ayushrath63/TeamToast2019/README.md

Team Toast - Micromouse 2018-2019
======
Created by Ayush Rath and Emily Chen

Hardware (PCB) and software used to build and program a Micromouse robot
