ayushrath63/TeamToast2019/PCB/ToastSchematic.brd

## EAGLE design PCB/ToastSchematic.brd (2019-01-23)

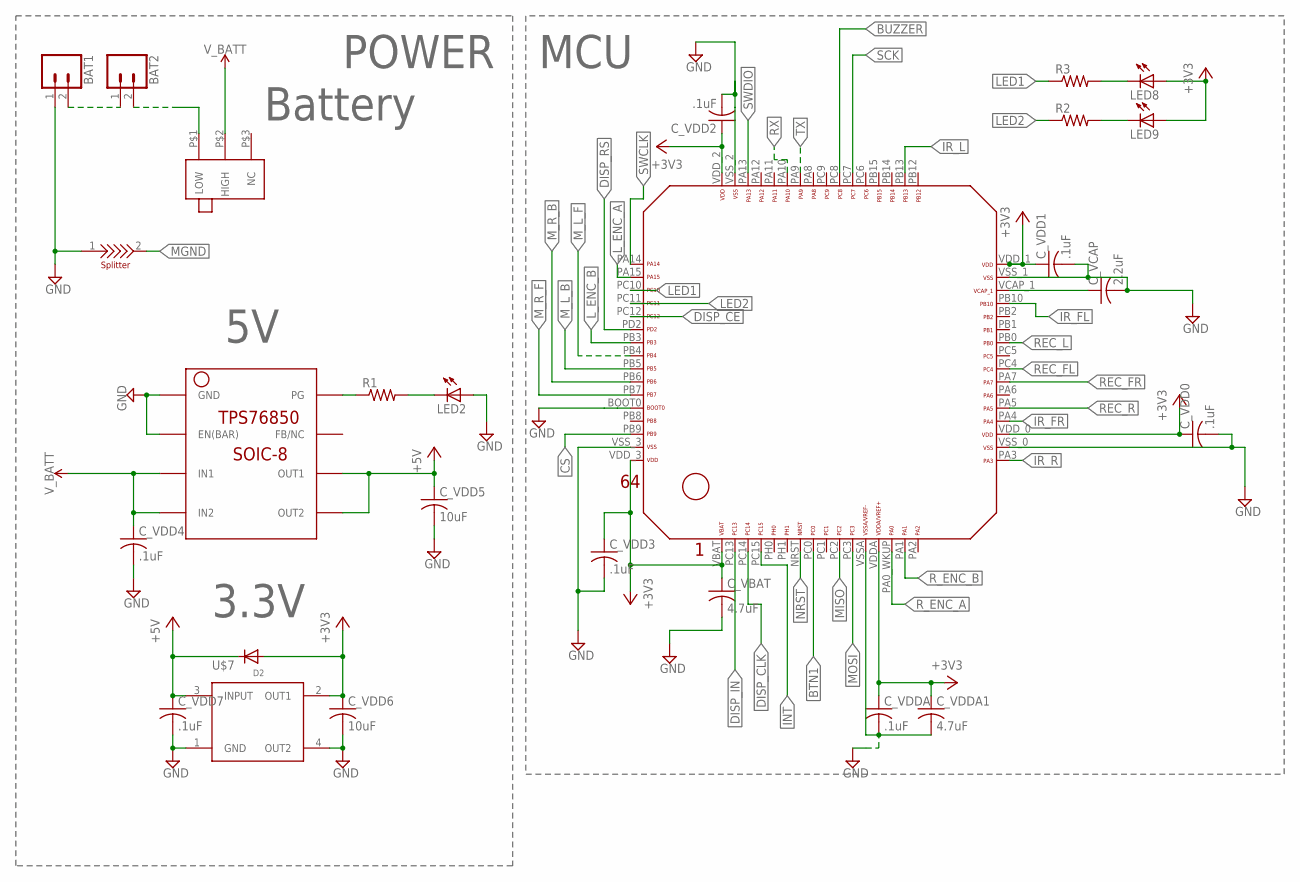
[picture p1: schematic ToastSchematic.sch, sheet 1]

Parts:
BAT1, BAT2: CONN_02JST-PTH-2; JST-2-PTH
C_VBAT: 4.7uF; C0603
C_VCAP: 2.2uF; C0603
C_VDD0, C_VDD1, C_VDD2, C_VDD3, C_VDD4, C_VDD7: .1uF; C0603
C_VDD5, C_VDD6: 10uF; C0603
C_VDDA: .1uF; C0603
C_VDDA1: 4.7uF; C0603
D2: DIODESOD-323F; SOD-323F
LED2, LED8, LED9: LEDCHIPLED_0603; CHIPLED_0603
R1, R2, R3: R-US_R0603; R0603
U$1: STM32F411/446_LQFP64
U$2: GH39P0
U$3: TPS76850(SOIC-8)
U$7: TLV1117; SOT-223
U$9: SPLITTER

Connections:
+3V3: C_VBAT.1, C_VDD0.1, C_VDD1.1, C_VDD2.1, C_VDD3.1, C_VDD6.1, C_VDDA.1, C_VDDA1.1, D2.A, LED8.A, LED9.A, U$1.VBAT, U$1.VDDA, U$1.VDD_0, U$1.VDD_1, U$1.VDD_2, U$1.VDD_3, U$7.2 (OUT1); also elsewhere on the board
+5V: C_VDD5.1, C_VDD7.1, D2.C, U$3.OUT1, U$3.OUT2, U$7.3 (INPUT); also elsewhere on the board
BTN1: U$1.PC0; also elsewhere on the board
BUZZER: U$1.PC8; also elsewhere on the board
CS: U$1.PB9; also elsewhere on the board
DISP_CE: U$1.PC12; also elsewhere on the board
DISP_CLK: U$1.PC14; also elsewhere on the board
DISP_IN: U$1.PC13; also elsewhere on the board
DISP_RS: U$1.PD2; also elsewhere on the board
GND: BAT1.1, C_VBAT.2, C_VCAP.2, C_VDD0.2, C_VDD1.2, C_VDD2.2, C_VDD3.2, C_VDD4.2, C_VDD5.2, C_VDD6.2, C_VDD7.2, C_VDDA.2, C_VDDA1.2, LED2.A, U$1.BOOT0, U$1.VSSA, U$1.VSS_0, U$1.VSS_1, U$1.VSS_2, U$1.VSS_3, U$3.EN(BAR), U$3.GND, U$7.1 (GND), U$7.4 (OUT2), U$9.1; also elsewhere on the board
INT: U$1.PC15; also elsewhere on the board
IR_FL: U$1.PB10; also elsewhere on the board
IR_FR: U$1.PA4; also elsewhere on the board
IR_L: U$1.PB13; also elsewhere on the board
IR_R: U$1.PA3; also elsewhere on the board
LED1: R3.1, U$1.PC10
LED2: R2.1, U$1.PC11
L_ENC_A: U$1.PA15; also elsewhere on the board
L_ENC_B: U$1.PB3; also elsewhere on the board
MGND: U$9.2; also elsewhere on the board
MISO: U$1.PC2; also elsewhere on the board
MOSI: U$1.PC3; also elsewhere on the board
M_L_B: U$1.PB5; also elsewhere on the board
M_L_F: U$1.PB4; also elsewhere on the board
M_R_B: U$1.PB6; also elsewhere on the board
M_R_F: U$1.PB7; also elsewhere on the board
unnamed: BAT1.2, BAT2.1
unnamed: BAT2.2, U$2.P$1 (LOW)
unnamed: C_VCAP.1, U$1.VCAP_1
unnamed: LED8.C, R3.2
unnamed: LED2.C, R1.2
unnamed: R1.1, U$3.PG
unnamed: LED9.C, R2.2
NRST: U$1.NRST; also elsewhere on the board
REC_FL: U$1.PC4; also elsewhere on the board
REC_FR: U$1.PA7; also elsewhere on the board
REC_L: U$1.PB0; also elsewhere on the board
REC_R: U$1.PA5; also elsewhere on the board
RX: U$1.PA10; also elsewhere on the board
R_ENC_A: U$1.PA0_WKUP (PA0_AKUP); also elsewhere on the board
R_ENC_B: U$1.PA1; also elsewhere on the board
SCK: U$1.PC7; also elsewhere on the board
SWCLK: U$1.PA14; also elsewhere on the board
SWDIO: U$1.PA13; also elsewhere on the board
TX: U$1.PA9; also elsewhere on the board
V_BATT: C_VDD4.1, U$2.P$2 (HIGH), U$3.IN1, U$3.IN2; also elsewhere on the board

Notes on the sheet:
MCU
POWER
3.3V
Battery

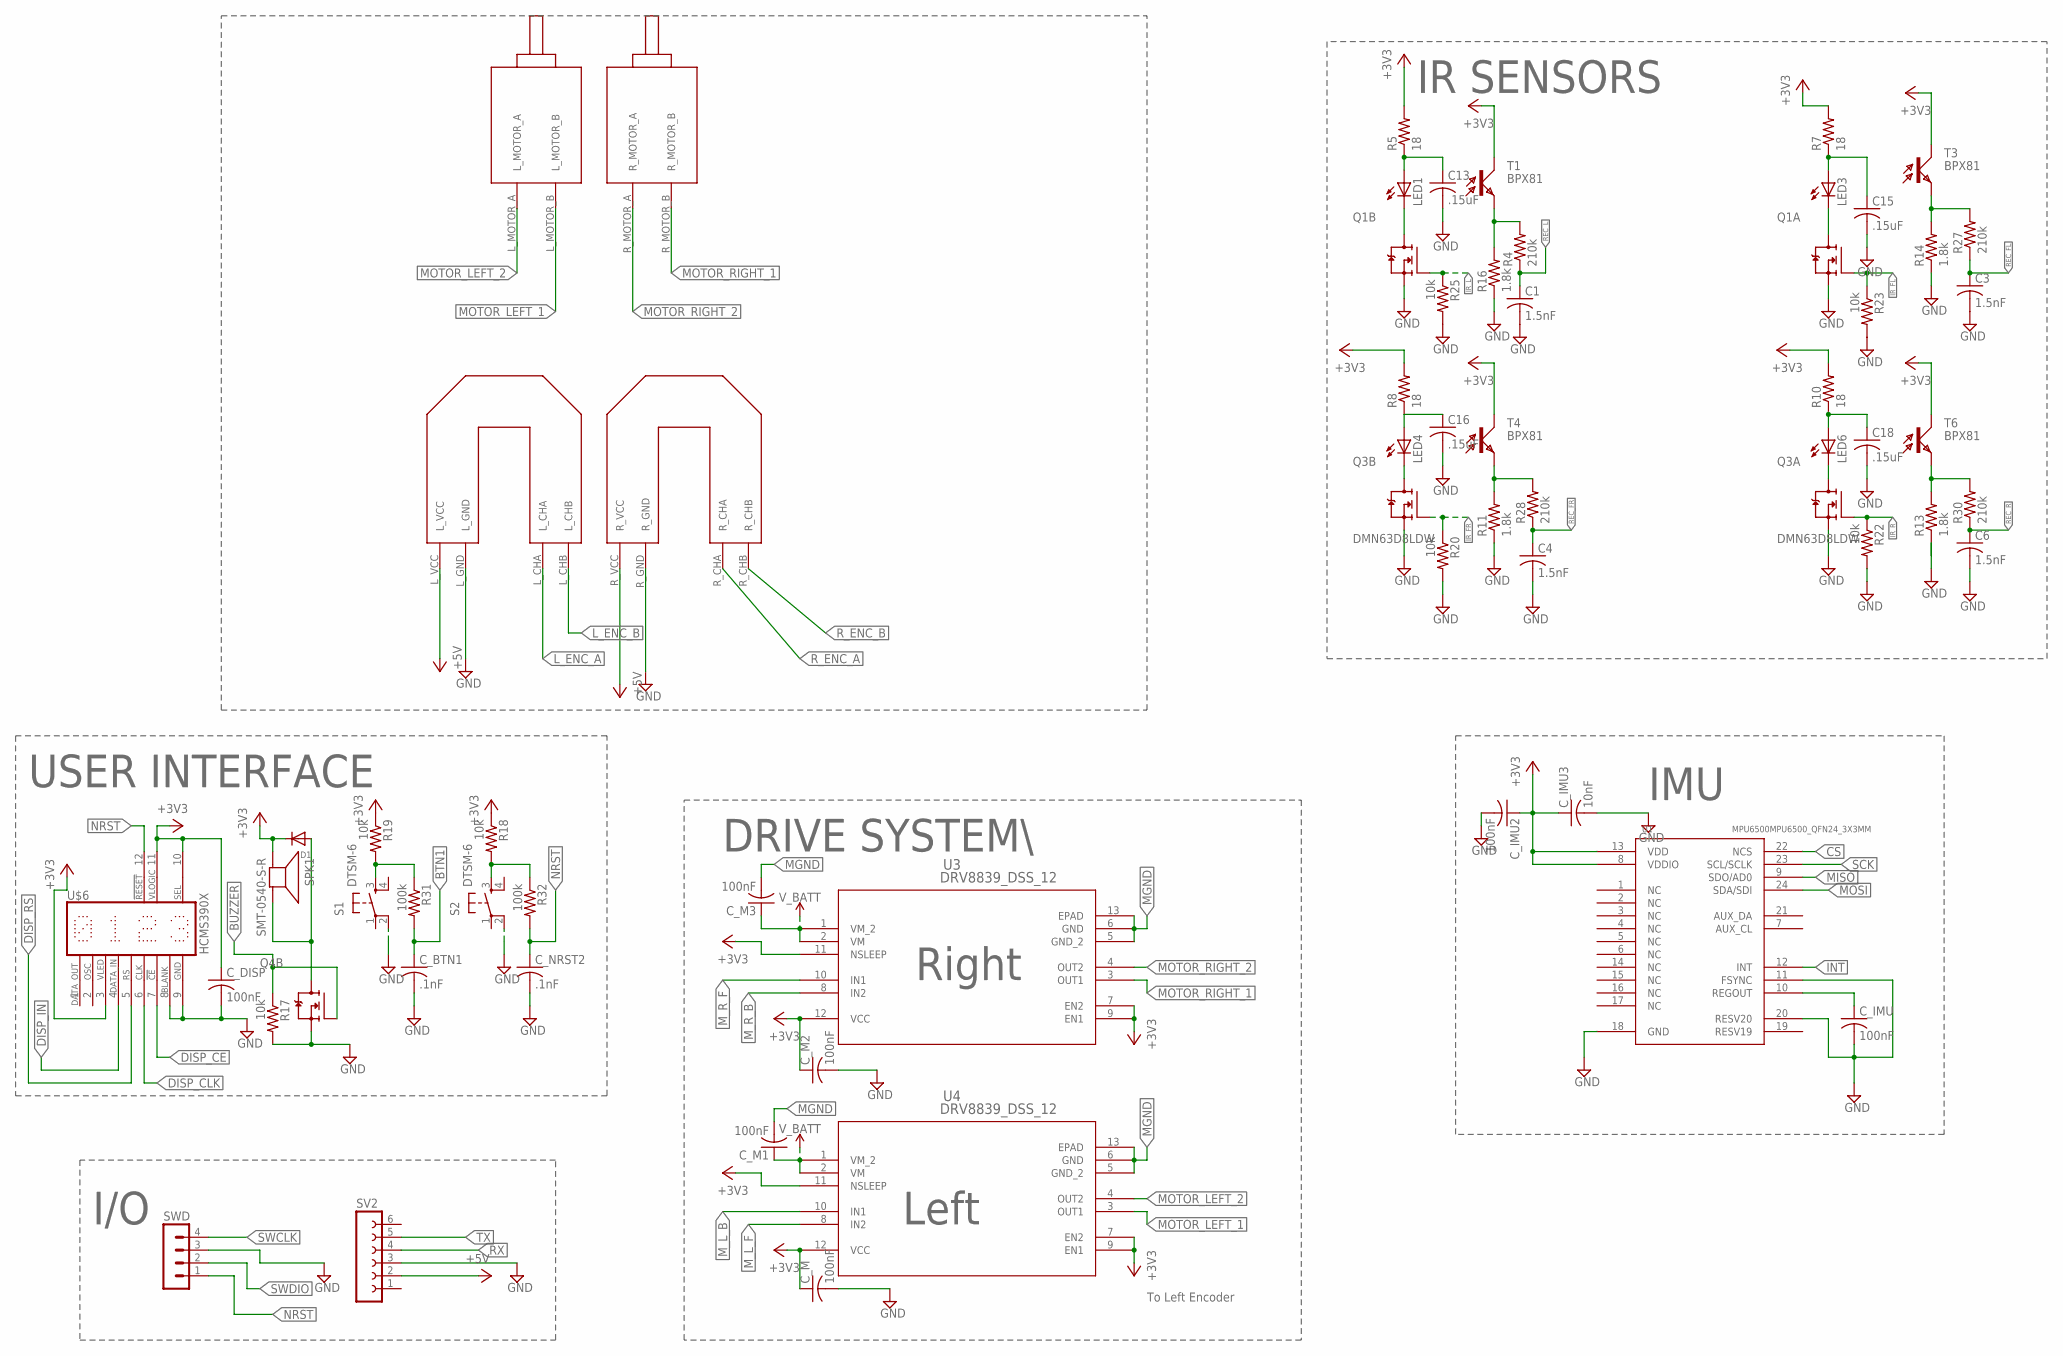
[picture p2: schematic ToastSchematic.sch, sheet 2]

Parts:
C1, C3, C4, C6: 1.5nF; C0603K
C13, C15, C16, C18: .15uF; C0603K
C_BTN1: .1nF; C0603K
C_DISP: 100nF; C0603K
C_IMU, C_IMU2: 100nF; C0603K
C_IMU3: 10nF; C0603K
C_M, C_M1, C_M2, C_M3: 100nF; C0603K
C_NRST2: .1nF; C0603K
D1: DIODESOD-323F; SOD-323F
LED1, LED3, LED4, LED6: LED5MM
Q1, Q3, Q4: DMN63D8LDW; SOT363
R4, R27, R28, R30: 210k; R0603
R5, R7, R8, R10: 18; R0603
R11, R13, R14, R16: 1.8k; R0603
R17, R18, R19, R20, R22, R23, R25: 10k; R0603
R31, R32: 100k; R0603
S1, S2: DTSM-6
SPK1: SMT-0540-S-R
SV2: FE06-1; FE06
SWD: MA04-1
T1, T3, T4, T6: BPX81
U1: MPU6500MPU6500_QFN24_3X3MM; QFN24_3X3MM
U3, U4: DRV8839_DSS_12; DSS12_P9X2
U$4: FUTURA_V1.0_MOTOR_MOUNT; FUTURA_V1.0_MOTOT_MOUNT
U$6: HCMS390X

Connections:
+3V3: C_DISP.1, C_IMU2.1, C_IMU3.1, C_M.1, C_M2.1, D1.C, R5.2, R7.2, R8.2, R10.2, R18.1, R19.1, SPK1.- (+), T1.C, T3.C, T4.C, T6.C, U1.8 (VDDIO), U1.13 (VDD), U3.7 (EN2), U3.9 (EN1), U3.11 (NSLEEP), U3.12 (VCC), U4.7 (EN2), U4.9 (EN1), U4.11 (NSLEEP), U4.12 (VCC), U$6.3 (VLED), U$6.10 (SEL), U$6.11 (VLOGIC); also elsewhere on the board
+5V: SV2.2, U$4.L_VCC, U$4.R_VCC; also elsewhere on the board
BTN1: C_BTN1.1, R31.2; also elsewhere on the board
BUZZER: Q4.5 (G), R17.1; also elsewhere on the board
CS: U1.22 (NCS); also elsewhere on the board
DISP_CE: U$6.7 (!CE); also elsewhere on the board
DISP_CLK: U$6.6 (CLK); also elsewhere on the board
DISP_IN: U$6.4 (IN); also elsewhere on the board
DISP_RS: U$6.5 (RS); also elsewhere on the board
GND: C1.2, C3.2, C4.2, C6.2, C13.2, C15.2, C16.2, C18.2, C_BTN1.2, C_DISP.2, C_IMU.2, C_IMU2.2, C_IMU3.2, C_M.2, C_M2.2, C_NRST2.2, Q1.1 (S), Q1.4 (S), Q3.1 (S), Q3.4 (S), Q4.4 (S), R11.1, R13.1, R14.1, R16.1, R17.2, R20.2, R22.2, R23.2, R25.2, S1.2, S2.2, SV2.3, SWD.3, U1.11 (FSYNC), U1.18 (GND), U1.20 (RESV20), U$4.L_GND, U$4.R_GND, U$6.8 (BLANK), U$6.9 (GND); also elsewhere on the board
INT: U1.12 (INT); also elsewhere on the board
IR_FL: Q1.2 (G), R23.1; also elsewhere on the board
IR_FR: Q3.5 (G), R20.1; also elsewhere on the board
IR_L: Q1.5 (G), R25.1; also elsewhere on the board
IR_R: Q3.2 (G), R22.1; also elsewhere on the board
L_ENC_A: U$4.L_CHA; also elsewhere on the board
L_ENC_B: U$4.L_CHB; also elsewhere on the board
MGND: C_M1.2, C_M3.2, U3.5 (GND_2), U3.6 (GND), U3.13 (EPAD), U4.5 (GND_2), U4.6 (GND), U4.13 (EPAD); also elsewhere on the board
MISO: U1.9 (SDO/AD0); also elsewhere on the board
MOSI: U1.24 (SDA/SDI); also elsewhere on the board
MOTOR_LEFT_1: U4.3 (OUT1), U$4.L_MOTOR_B
MOTOR_LEFT_2: U4.4 (OUT2), U$4.L_MOTOR_A
MOTOR_RIGHT_1: U3.3 (OUT1), U$4.R_MOTOR_B
MOTOR_RIGHT_2: U3.4 (OUT2), U$4.R_MOTOR_A
M_L_B: U4.10 (IN1); also elsewhere on the board
M_L_F: U4.8 (IN2); also elsewhere on the board
M_R_B: U3.8 (IN2); also elsewhere on the board
M_R_F: U3.10 (IN1); also elsewhere on the board
unnamed: C13.1, LED1.A, R5.1
unnamed: LED1.K (C), Q1.3 (D)
unnamed: R19.2, R31.1, S1.3
unnamed: LED3.K (C), Q1.6 (D)
unnamed: R18.2, R32.1, S2.3
unnamed: C18.1, LED6.A, R10.1
unnamed: LED6.K (C), Q3.6 (D)
unnamed: C16.1, LED4.A, R8.1
unnamed: C_IMU.1, U1.10 (REGOUT)
unnamed: LED4.K (C), Q3.3 (D)
unnamed: D1.A, Q4.3 (D), SPK1.+ (-)
unnamed: R4.2, R16.2, T1.E
unnamed: R14.2, R27.2, T3.E
unnamed: R11.2, R28.2, T4.E
unnamed: R13.2, R30.2, T6.E
unnamed: C15.1, LED3.A, R7.1
NRST: C_NRST2.1, R32.2, SWD.1, U$6.12 (NOT_RESET); also elsewhere on the board
REC_FL: C3.1, R27.1; also elsewhere on the board
REC_FR: C4.1, R28.1; also elsewhere on the board
REC_L: C1.1, R4.1; also elsewhere on the board
REC_R: C6.1, R30.1; also elsewhere on the board
RX: SV2.4; also elsewhere on the board
R_ENC_A: U$4.R_CHA; also elsewhere on the board
R_ENC_B: U$4.R_CHB; also elsewhere on the board
SCK: U1.23 (SCL/SCLK); also elsewhere on the board
SWCLK: SWD.4; also elsewhere on the board
SWDIO: SWD.2; also elsewhere on the board
TX: SV2.5; also elsewhere on the board
V_BATT: C_M1.1, C_M3.1, U3.1 (VM_2), U3.2 (VM), U4.1 (VM_2), U4.2 (VM); also elsewhere on the board

Notes on the sheet:
DRIVE SYSTEM\
Right
Left
USER INTERFACE
IR SENSORS
IMU
I/O
To Left Encoder

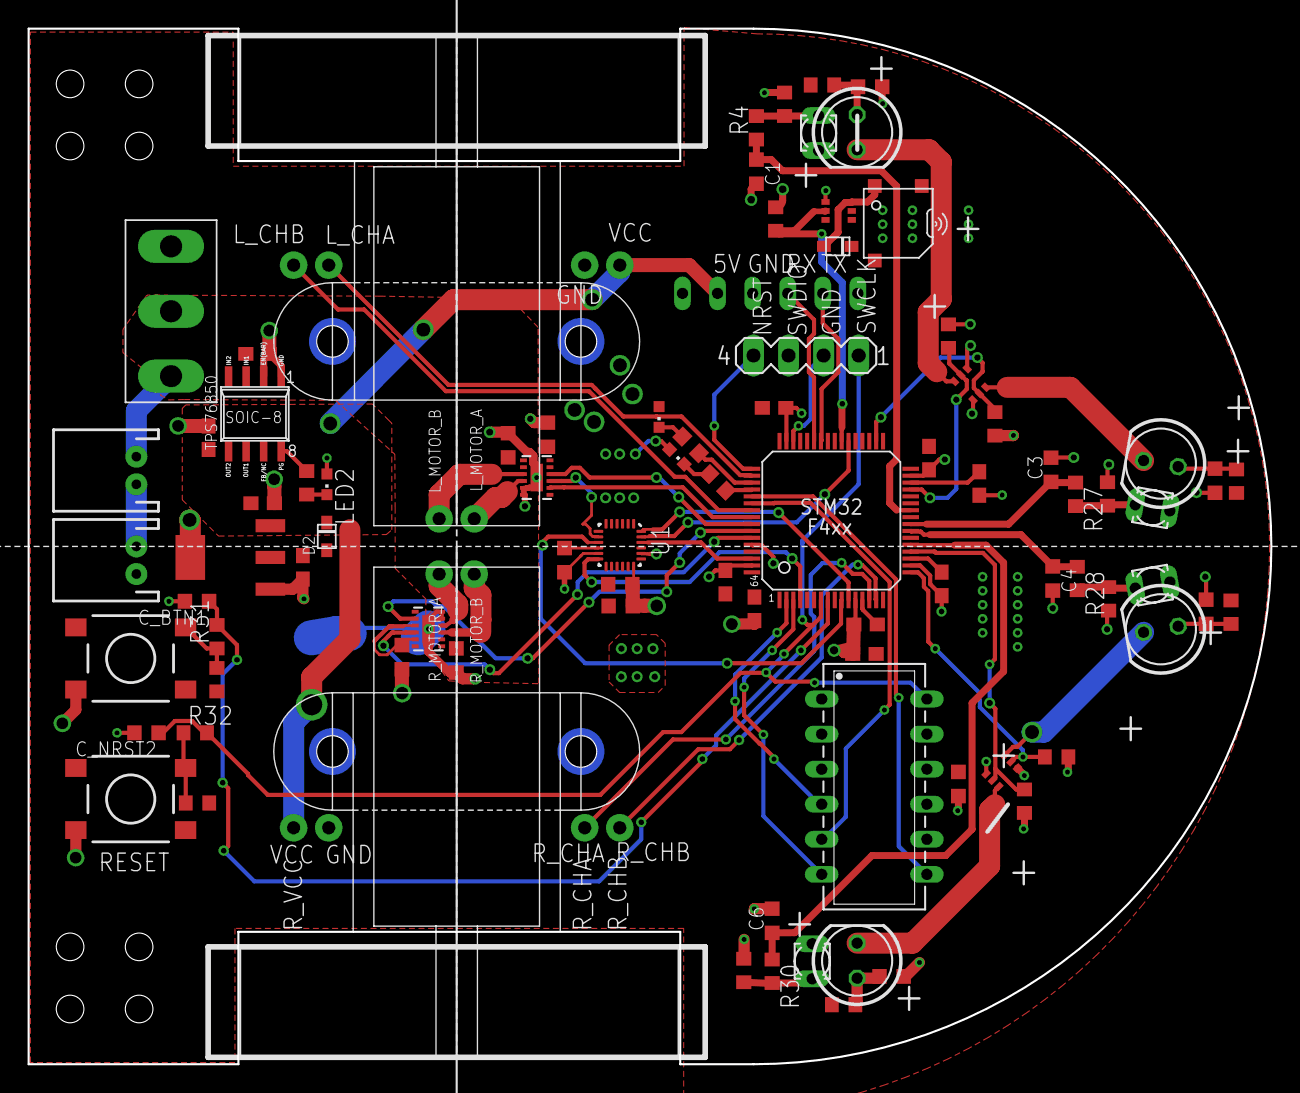
[picture p3: board ToastSchematic.brd from above]

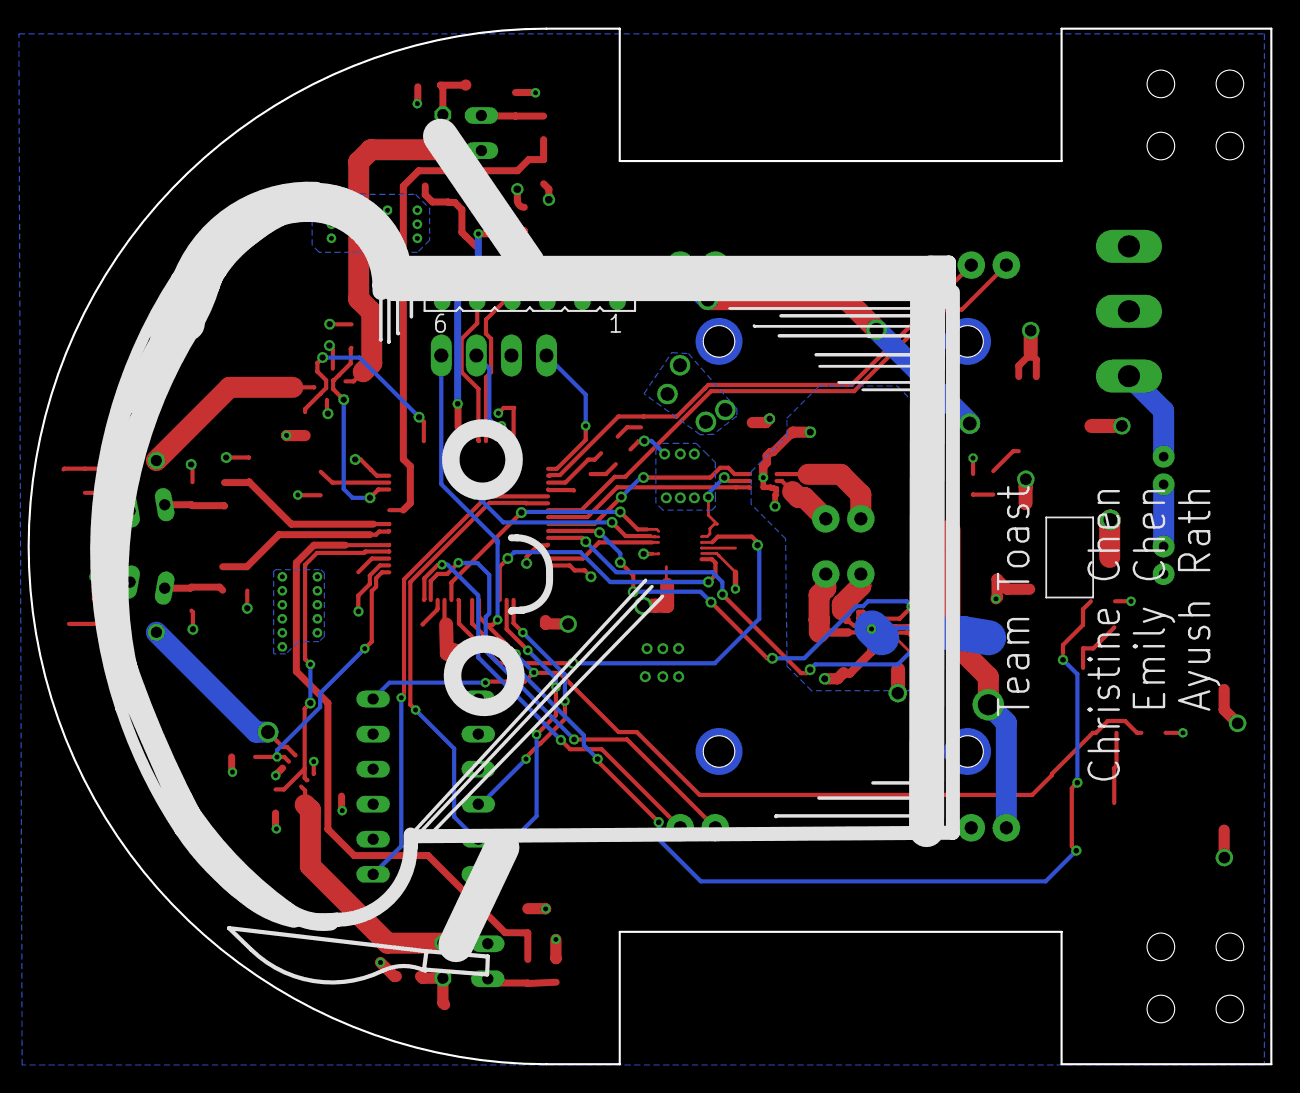
[picture p4: board ToastSchematic.brd from below]

Board: 2 copper layers, 90.0 x 75.0 mm, 87 parts (2 on the bottom side), 66 nets.
