ayushrath63/TeamToast2019/Code/src/main.cpp

/**
  ******************************************************************************
  * @file           : main.c
  * @brief          : Main program body
  ******************************************************************************
  ** This notice applies to any and all portions of this file
  * that are not between comment pairs USER CODE BEGIN and
  * USER CODE END. Other portions of this file, whether 
  * inserted by the user or by software development tools
  * are owned by their respective copyright owners.
  *
  * COPYRIGHT(c) 2019 STMicroelectronics
  *
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
  ******************************************************************************
  */
/* Includes ------------------------------------------------------------------*/
#include "main.h"
#include "stm32f4xx_hal.h"
#include "adc.h"
#include "spi.h"
#include "tim.h"
#include "usart.h"
#include "gpio.h"


/* USER CODE BEGIN Includes */
#define SWO_DEBUG_ENABLED 0
/* USER CODE END Includes */


/* USER CODE BEGIN PV */

/* USER CODE END PV */

void SystemClock_Config(void);

/* USER CODE BEGIN PFP */

/* USER CODE END PFP */

/**
  * @brief  The application entry point.
  *
  * @retval None
  */
int main(void)
{
  /* MCU Configuration----------------------------------------------------------*/

  /* Reset of all peripherals, Initializes the Flash interface and the Systick. */
  HAL_Init();

  /* Configure the system clock */
  SystemClock_Config();

  /* Initialize all configured peripherals */
  MX_GPIO_Init();
  MX_ADC1_Init();
  MX_SPI2_Init();
  MX_USART1_UART_Init();
  MX_TIM4_Init();
  MX_TIM3_Init();
  MX_TIM5_Init();
  MX_TIM2_Init();
  /* USER CODE BEGIN 2 */

  //Undocumented stuff, needed to start encoder
  HAL_TIM_Encoder_Start(&htim2, TIM_CHANNEL_1 | TIM_CHANNEL_2);
  TIM2->EGR=TIM_EGR_UG;
  TIM2->CR1=TIM_CR1_CEN;

  //Undocumented stuff, needed to start encoder
  HAL_TIM_Encoder_Start(&htim5,  TIM_CHANNEL_1 | TIM_CHANNEL_2);
  TIM5->EGR=TIM_EGR_UG;
  TIM5->CR1=TIM_CR1_CEN;

  HAL_TIM_Base_Start(&htim3);

  HAL_TIM_Base_Start(&htim4);

  uint8_t buf[2];
  buf[0] = 0x6A; //User control reg
  buf[1] = 0x10; //I2c disable bit

  HAL_GPIO_WritePin(IMU_nCS_GPIO_Port, IMU_nCS_Pin, GPIO_PIN_RESET);
  HAL_SPI_Transmit(&hspi2, buf, sizeof(buf), 100);
  HAL_GPIO_WritePin(IMU_nCS_GPIO_Port, IMU_nCS_Pin, GPIO_PIN_SET);
  HAL_Delay(10);

  buf[0] = 0x6B; //power mgmt register
  buf[1] = 0x80; //reset
  HAL_GPIO_WritePin(IMU_nCS_GPIO_Port, IMU_nCS_Pin, GPIO_PIN_RESET);
  HAL_SPI_Transmit(&hspi2, buf, sizeof(buf), 100);
  HAL_GPIO_WritePin(IMU_nCS_GPIO_Port, IMU_nCS_Pin, GPIO_PIN_SET);
  HAL_Delay(10);

  buf[0] = 0x68; //signal path
  buf[1] = 0x07; //reset
  HAL_GPIO_WritePin(IMU_nCS_GPIO_Port, IMU_nCS_Pin, GPIO_PIN_RESET);
  HAL_SPI_Transmit(&hspi2, buf, sizeof(buf), 100);
  HAL_GPIO_WritePin(IMU_nCS_GPIO_Port, IMU_nCS_Pin, GPIO_PIN_SET);
  HAL_Delay(10);

  buf[0] = 0x6B; //signal path
  buf[1] = 0x03; //gyro pll select
  HAL_GPIO_WritePin(IMU_nCS_GPIO_Port, IMU_nCS_Pin, GPIO_PIN_RESET);
  HAL_SPI_Transmit(&hspi2, buf, sizeof(buf), 100);
  HAL_GPIO_WritePin(IMU_nCS_GPIO_Port, IMU_nCS_Pin, GPIO_PIN_SET);
  HAL_Delay(10);

  //IMU -> read WHOAMI reg
  uint8_t addr, data;
  addr = 0x75 | 0x80; // WHOAMI | read flag
  data = 0;
  HAL_GPIO_WritePin(IMU_nCS_GPIO_Port, IMU_nCS_Pin, GPIO_PIN_RESET);
  HAL_SPI_Transmit(&hspi2, &addr, sizeof(addr), 100);
  HAL_SPI_Receive(&hspi2, &data, sizeof(data), 100);
  HAL_GPIO_WritePin(IMU_nCS_GPIO_Port, IMU_nCS_Pin, GPIO_PIN_SET);
  HAL_Delay(10);
  if(data != 0x70)
  {
    char printbuf[32] = "ERROR";
    //sprintf(printbuf, "WHOAMI: %hd\r\n", data);
    print((uint8_t*)printbuf);
  }
  
  //Notes:
  /*
  Registers 19 to 24 – Gyro Offset Registers
  25 -> sample rate divider
  26-> config
  */
  //Configuration
  //set sample rate to 1khz
  buf[0] = 0x19; //Sample rate divider
  buf[1] = 0x00; //1KHz
  HAL_GPIO_WritePin(IMU_nCS_GPIO_Port, IMU_nCS_Pin, GPIO_PIN_RESET);
  HAL_SPI_Transmit(&hspi2, buf, sizeof(buf), 100);
  HAL_GPIO_WritePin(IMU_nCS_GPIO_Port, IMU_nCS_Pin, GPIO_PIN_SET);
  HAL_Delay(10);

  //setup dlpf
  buf[0] = 0x1A; //Config
  buf[1] = 0x01; //DLPF -> 184Hz
  HAL_GPIO_WritePin(IMU_nCS_GPIO_Port, IMU_nCS_Pin, GPIO_PIN_RESET);
  HAL_SPI_Transmit(&hspi2, buf, sizeof(buf), 100);
  HAL_GPIO_WritePin(IMU_nCS_GPIO_Port, IMU_nCS_Pin, GPIO_PIN_SET);
  HAL_Delay(10);
  
  //set scale
  buf[0] = 0x1A; //Gyro Config
  buf[1] = 0x18; //FS -> 2000dps
  HAL_GPIO_WritePin(IMU_nCS_GPIO_Port, IMU_nCS_Pin, GPIO_PIN_RESET);
  HAL_SPI_Transmit(&hspi2, buf, sizeof(buf), 100);
  HAL_GPIO_WritePin(IMU_nCS_GPIO_Port, IMU_nCS_Pin, GPIO_PIN_SET);
  HAL_Delay(10);


  /* USER CODE END 2 */

  /* Infinite loop */
  /* USER CODE BEGIN WHILE */

  while (1)
  {
    HAL_GPIO_TogglePin(GPIOC, GPIO_PIN_10);
    
    setPWM(htim3, TIM_CHANNEL_1, 255, 127);
    setPWM(htim4, TIM_CHANNEL_1, 255, 127);
    

    // char buf[16];
    // sprintf(buf, "2:%d, 5:%d\r\n", TIM2->CNT, TIM5->CNT);

    // print((uint8_t*)buf);

    uint8_t addrH = 0x47 | 0x80; // Gyro Z high byte | read flag
    uint8_t addrL = 0x48 | 0x80; // Gyro Z high byte | read flag
    int16_t gzData;
    uint8_t dataH, dataL;
    HAL_GPIO_WritePin(IMU_nCS_GPIO_Port, IMU_nCS_Pin, GPIO_PIN_RESET);
    HAL_SPI_Transmit(&hspi2, &addrH, sizeof(addrH), 100);
    HAL_SPI_Receive(&hspi2, &dataH, sizeof(dataH), 100);
    HAL_SPI_Transmit(&hspi2, &addrL, sizeof(addrL), 100);
    HAL_SPI_Receive(&hspi2, &dataL, sizeof(dataL), 100);
    HAL_GPIO_WritePin(IMU_nCS_GPIO_Port, IMU_nCS_Pin, GPIO_PIN_SET);
    HAL_Delay(10);

    gzData = ((int16_t)dataH) << 8 | ((int16_t)dataL);
    char gzbuf[64];
    sprintf(gzbuf, "GyroZ: %d, %d, %hd\r\n", dataH, dataL, gzData);
    print((uint8_t*)gzbuf);
    HAL_Delay(100);
  /* USER CODE END WHILE */

  /* USER CODE BEGIN 3 */

  }
  /* USER CODE END 3 */ 

}

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
