ayushrath63/TeamToast2019/Code/TeamToast.ioc

Mcu.UserName=STM32F411RETx
PA0-WKUP.GPIO_Label=R_Encoder_A
PA0-WKUP.Signal=S_TIM5_CH1
PA1.GPIO_Label=R_Encoder_B
PA1.Signal=S_TIM5_CH2
PA10.Signal=USART1_RX
PA13.Signal=SYS_JTMS-SWDIO
PA14.Signal=SYS_JTCK-SWCLK
PA15.GPIO_Label=L_Encoder_A
PA15.Signal=S_TIM2_CH1_ETR
PA3.GPIO_Label=IR_R
PA3.Signal=GPIO_Output
PA4.GPIO_Label=IR_FR
PA4.Signal=GPIO_Output
PA5.GPIO_Label=Rec_R
PA5.Signal=ADCx_IN5
PA7.GPIO_Label=Rec_FR
PA7.Signal=ADCx_IN7
PA9.Signal=USART1_TX
PB0.GPIO_Label=Rec_L
PB0.Signal=ADCx_IN8
PB10.GPIO_Label=IR_FL
PB10.Signal=GPIO_Output
PB13.GPIO_Label=IR_L
PB13.Signal=GPIO_Output
PB3.GPIO_Label=L_Encoder_B
PB3.Signal=S_TIM2_CH2
PB4.GPIO_Label=Motor_L_F
PB4.Signal=S_TIM3_CH1
PB5.GPIO_Label=Motor_L_B
PB5.Signal=S_TIM3_CH2
PB6.GPIO_Label=Motor_R_B
PB6.Signal=S_TIM4_CH1
PB7.GPIO_Label=Motor_R_F
PB7.Signal=S_TIM4_CH2
PB9.GPIO_Label=IMU_nCS
PB9.Signal=GPIO_Output
PC0.GPIO_Label=Btn1
PC0.Signal=GPIO_Input
PC10.GPIO_Label=LED1
PC10.Signal=GPIO_Output
PC11.GPIO_Label=LED2
PC11.Signal=GPIO_Output
PC12.GPIO_Label=Disp_CE
PC12.Signal=GPIO_Output
PC13-ANTI_TAMP.GPIO_Label=Disp_In
PC13-ANTI_TAMP.Signal=GPIO_Output
PC14-OSC32_IN.GPIO_Label=Disp_Clk
PC14-OSC32_IN.Signal=GPIO_Output
PC15-OSC32_OUT.GPIO_Label=IMU_Int
PC15-OSC32_OUT.Signal=GPIO_Input
PC2.GPIO_Label=IMU_MISO
PC2.Signal=SPI2_MISO
PC3.GPIO_Label=IMU_MOSI
PC3.Signal=SPI2_MOSI
PC4.GPIO_Label=Rec_FL
PC4.Signal=ADCx_IN14
PC7.Signal=SPI2_SCK
PC8.GPIO_Label=Buzzer
PC8.Signal=GPIO_Output
PD2.GPIO_Label=Disp_RS
PD2.Signal=GPIO_Output
