ayushrath63/TeamToast2019/Code/src/BSP/IRSensor.cpp

#include "IRSensor.hpp"

IRSensor IRLeft(&hadc1, ADC_CHANNEL_8, IR_L_GPIO_Port, IR_L_Pin);
IRSensor IRTopLeft(&hadc1, ADC_CHANNEL_14, IR_FL_GPIO_Port, IR_FL_Pin);
IRSensor IRTopRight(&hadc1, ADC_CHANNEL_7, IR_FR_GPIO_Port, IR_FR_Pin);

IRSensor::IRSensor (ADC_HandleTypeDef* adcHandle, uint32_t channel, GPIO_TypeDef* GPIOx, uint16_t GPIO_Pin) {
    m_adcHandle = adcHandle;
    m_channel = channel;
    m_GPIOx = GPIOx;
    m_GPIO_Pin = GPIO_Pin;
    m_val = 0; 
}

int IRSensor::read() volatile {

    uint32_t ADC_VAL;
    HAL_GPIO_WritePin(m_GPIOx, m_GPIO_Pin, GPIO_PIN_SET);
    ADC_VAL = readADC(m_adcHandle,m_channel, 500);
    //HAL_Delay(1);
    HAL_GPIO_WritePin(m_GPIOx, m_GPIO_Pin, GPIO_PIN_RESET);
    m_val = ADC_VAL;
    return ADC_VAL; 
}

int IRSensor::value() volatile{
    return m_val;
}

void IRSensor_readAll() {
    IRLeft.read();
    IRTopLeft.read();
    IRTopRight.read();

}

bool ifdetectedFrontWall() {
    return (IRLeft.value() > OPEN_F);
}
bool ifdetectedRightWall() {
    return (IRTopRight.value() > OPEN_R);
}

bool ifdetectedLeftWall() {
    // if(IRLeft.value() > OPEN_F)
    //     return IRTopLeft.value() > 2100;
    // else
    return (IRTopLeft.value() >  OPEN_L);
} 
