ayushrath63/TeamToast2019/(commit log)

2019-01-23 Add PCB
    [ToastSchematic.brd, ToastSchematic.sch]
2019-01-23 Added Template Code
    [ToastSchematic.brd, ToastSchematic.sch]
2019-01-23 Fix directory structure
    [ToastSchematic.brd, ToastSchematic.sch]
2019-04-11 right encoder working
2019-04-11 encoder is kill
2019-04-25 Test gyro, working encoders, motors
2019-04-26 Working IMU, Motors, Encoders
2019-05-01 ADC test
2019-05-02 IMU class cteated
2019-05-07 motor class added
2019-05-15 Testing motor
2019-05-15 Test IR Sensors
2019-05-16 Fix motors
2019-05-16 add PID class
2019-05-22 PID value set
2019-05-23 Gyro PID turn
2019-05-26 Add encoder angle PID
2019-05-26 changed sensor value
2019-05-27 remove broken motion profile
    [Drive.hpp, Toast.cpp]
2019-05-27 Fix PID stop conditions
    [Drive.cpp, PID.hpp]
2019-05-28 Update IR values, broke drive logic?
    [Drive.cpp, IRSensor.cpp, IRSensor.hpp, Toast.cpp]
2019-05-28 Implement IR PID (untested
2019-05-28 Update IR constants again, drive logic still broken
    [Drive.cpp, IRSensor.cpp, IRSensor.hpp, Toast.cpp]
2019-05-29 Try new PID func
2019-05-30 fixed IR PID
2019-06-02 buggy code with queue
    [BitVector256.h, Drive.cpp, Floodfill.cpp, Floodfill.hpp, Maze.cpp, Maze.h, Toast.cpp, main.h]
